sww1235/row_staggered_split_keyboard/right-pcb/row_staggered_split_keyboard_right_side.kicad_pcb

## KiCad design right-pcb/row_staggered_split_keyboard_right_side.kicad_pcb (2026-11-07)

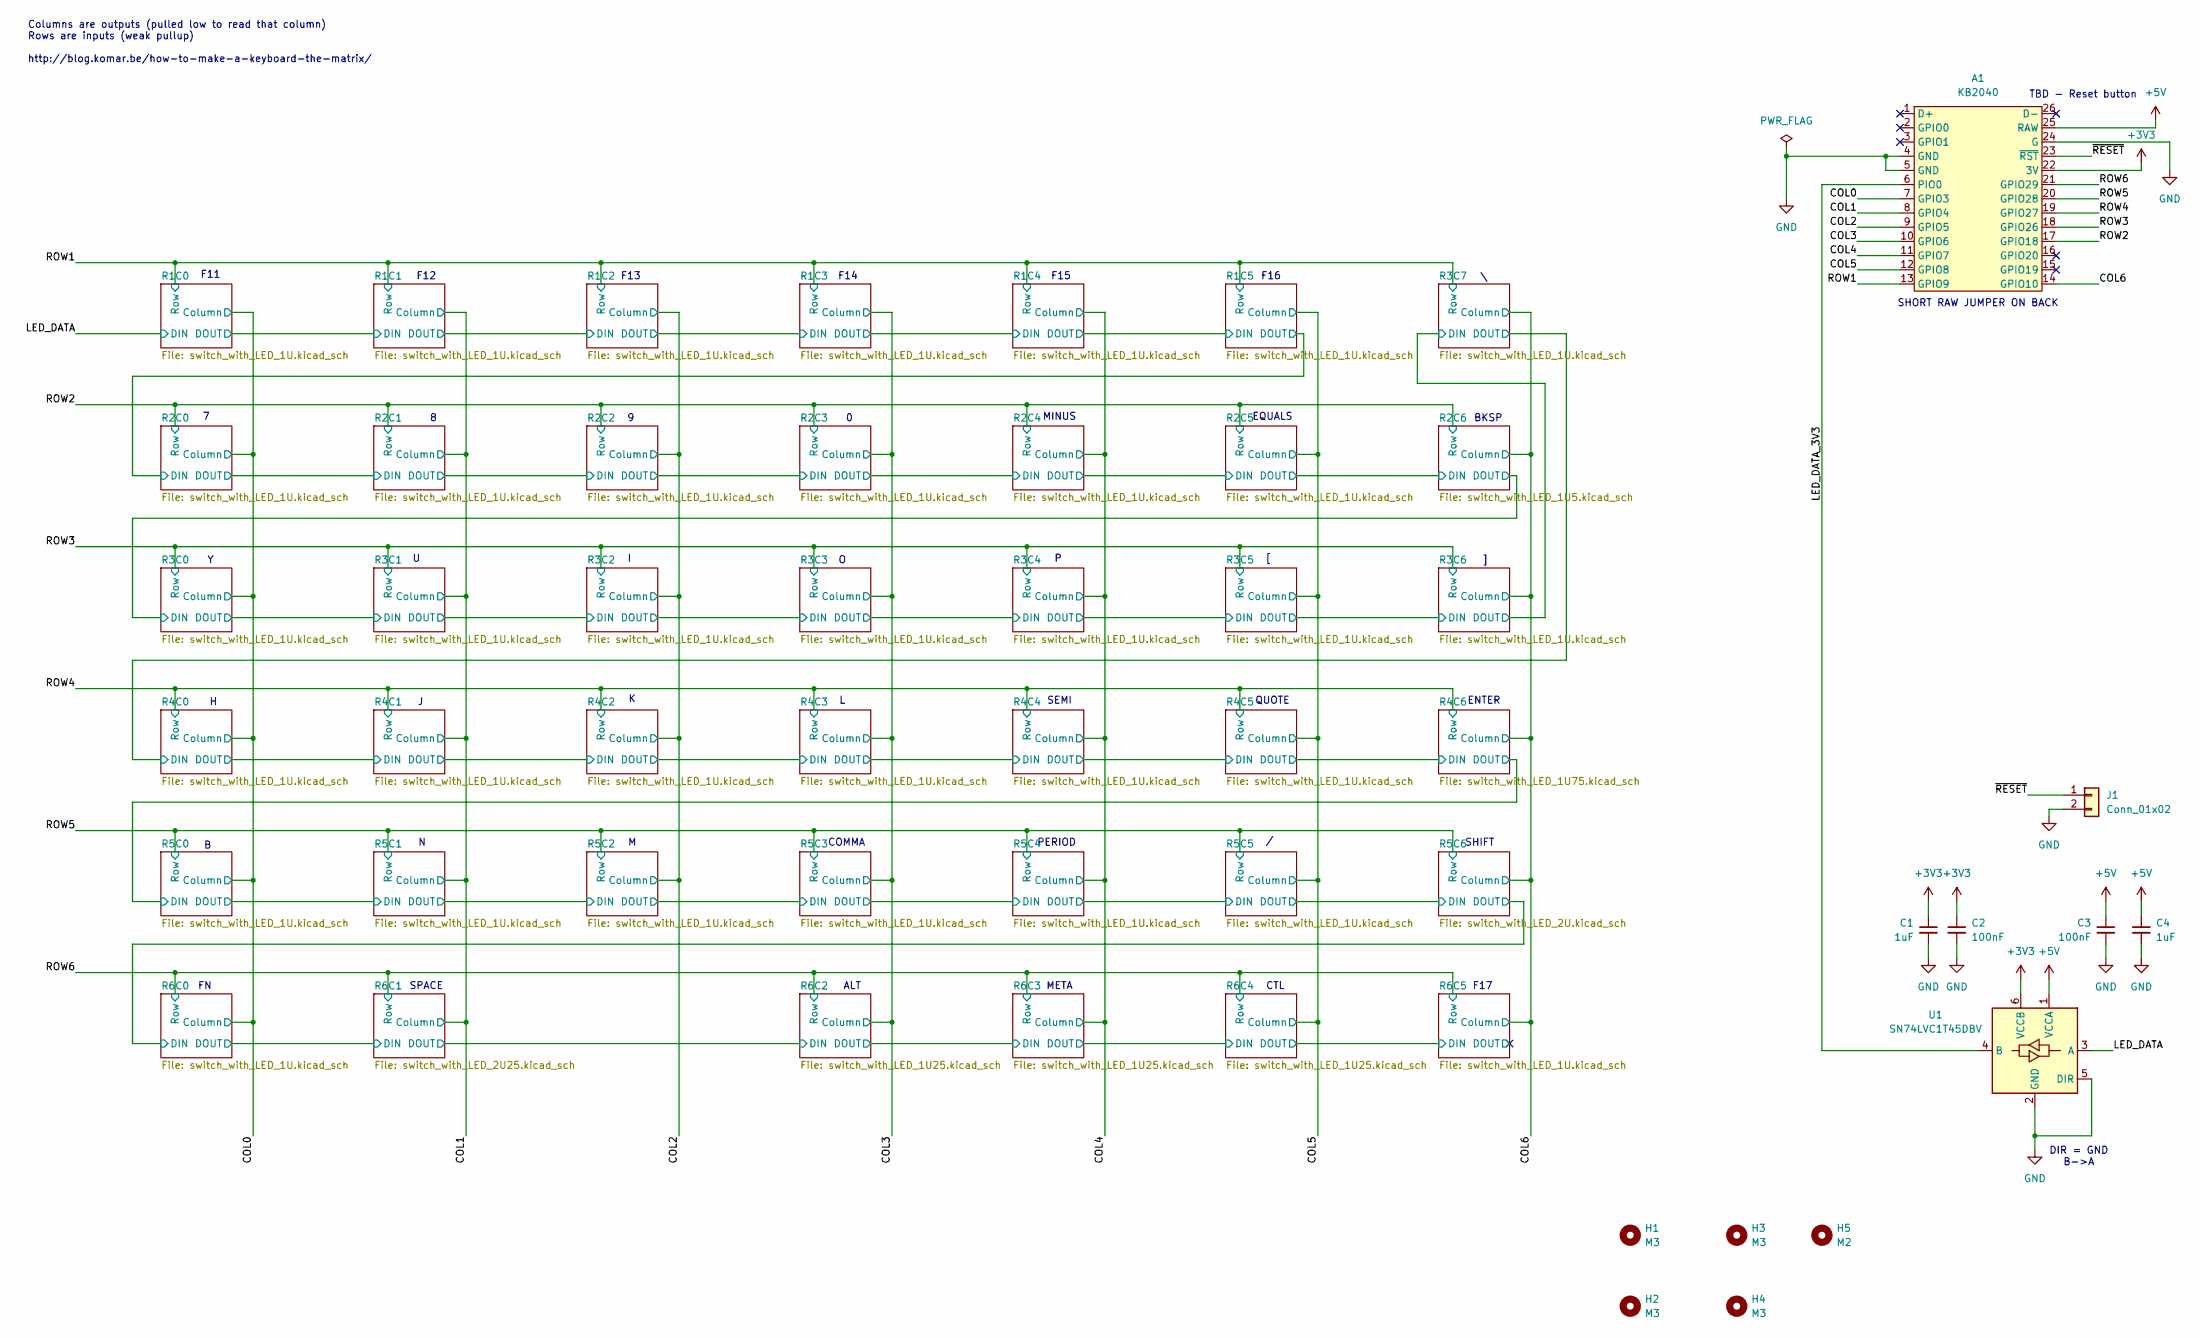
[picture p1: schematic row_staggered_split_keyboard_right_side.kicad_sch]

Parts:
A1: KB2040; KB2024_Socketed
C1, C4: 1uF; C_0805_2012Metric_Pad1.18x1.45mm_HandSolder
C2, C3: 100nF; C_0805_2012Metric_Pad1.18x1.45mm_HandSolder
H1, H2, H3, H4: M3; MountingHole_3.2mm_M3_ISO14580
H5: M2; MountingHole_2.2mm_M2
J1: Conn_01x02; PinSocket_1x02_P2.54mm_Vertical
U1: SN74LVC1T45DBV; SOT-23-6

Connections:
+3V3: A1.22 (3V), C1.1, C2.1, U1.6 (VCCB)
+5V: A1.25 (RAW), C3.1, C4.1, U1.1 (VCCA); also elsewhere on the board
/COL0: A1.7 (GPIO3); also elsewhere on the board
/COL1: A1.8 (GPIO4); also elsewhere on the board
/COL2: A1.9 (GPIO5); also elsewhere on the board
/COL3: A1.10 (GPIO6); also elsewhere on the board
/COL4: A1.11 (GPIO7); also elsewhere on the board
/COL5: A1.12 (GPIO8); also elsewhere on the board
/COL6: A1.14 (GPIO10); also elsewhere on the board
/LED_DATA: U1.3 (A); also elsewhere on the board
/LED_DATA_3V3: A1.6 (PIO0), U1.4 (B)
/ROW1: A1.13 (GPIO9); also elsewhere on the board
/ROW2: A1.17 (GPIO18); also elsewhere on the board
/ROW3: A1.18 (GPIO26); also elsewhere on the board
/ROW4: A1.19 (GPIO27); also elsewhere on the board
/ROW5: A1.20 (GPIO28); also elsewhere on the board
/ROW6: A1.21 (GPIO29); also elsewhere on the board
/~RESET: A1.23 (~RST), J1.1
GND: A1.4 (GND), A1.5 (GND), A1.24 (G), C1.2, C2.2, C3.2, C4.2, J1.2, U1.2 (GND), U1.5 (DIR); also elsewhere on the board

Notes on the sheet:
SHORT RAW JUMPER ON BACK
SPACE
DIR = GND B->A
ENTER
SHIFT
EQUALS
BKSP
F14
F15
META
MINUS
CTL
ALT
COMMA
QUOTE
F12
SEMI
F17
F13
F16
PERIOD
TBD - Reset button
Columns are outputs (pulled low to read that column) Rows are inputs (weak pullup) http://blog.komar.be/how-to-make-a-keyboard-the-matrix/
F11

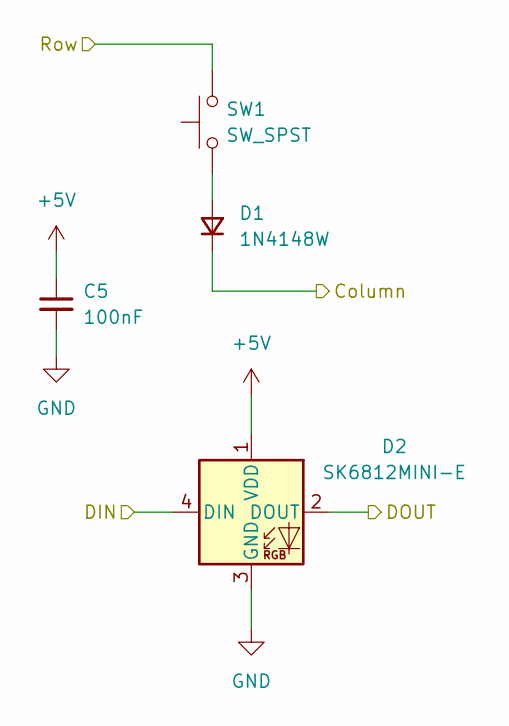
[picture p2: schematic switch_with_LED_1U.kicad_sch]

Parts:
C5: 100nF; C_0805_2012Metric_Pad1.18x1.45mm_HandSolder
D1: 1N4148W; D_SOD-123
D2: SK6812MINI-E; LED_SK6812MINI-E_REVERSE_MOUNT_3.2x2.8mm_P1.09mm
SW1: SW_SPST; SW_Hotswap_Kailh_MX_1.00u

Connections:
+5V: C5.1, D2.1 (VDD); also elsewhere on the board
/COL0: D1.1 (K); also elsewhere on the board
/LED_DATA: D2.4 (DIN); also elsewhere on the board
/R1C0/DOUT: D2.2 (DOUT); also elsewhere on the board
/ROW1: SW1.2; also elsewhere on the board
GND: C5.2, D2.3 (GND); also elsewhere on the board
unnamed: D1.2 (A), SW1.1

Parts of its further copies:
C6, C7, C8, C9, C10, C11, C12, C13, C14, C15, C16, C18, C19, C20, C21, C22, C23, C24, C25, C26, C27, C28, C29, C30, C31, C33, C34, C35, C36, C37, C38, C40, C45: 100nF; C_0805_2012Metric_Pad1.18x1.45mm_HandSolder
D3, D5, D7, D9, D11, D13, D15, D17, D19, D21, D23, D27, D29, D31, D33, D35, D37, D39, D41, D43, D45, D47, D49, D51, D53, D57, D59, D61, D63, D65, D67, D71, D81: 1N4148W; D_SOD-123
D4, D6, D8, D10, D12, D14, D16, D18, D20, D22, D24, D28, D30, D32, D34, D36, D38, D40, D42, D44, D46, D48, D50, D52, D54, D58, D60, D62, D64, D66, D68, D72, D82: SK6812MINI-E; LED_SK6812MINI-E_REVERSE_MOUNT_3.2x2.8mm_P1.09mm
SW2, SW3, SW4, SW5, SW6, SW7, SW8, SW9, SW10, SW11, SW12, SW14, SW15, SW16, SW17, SW18, SW19, SW20, SW21, SW22, SW23, SW24, SW25, SW26, SW27, SW29, SW30, SW31, SW32, SW33, SW34, SW36, SW41: SW_SPST; SW_Hotswap_Kailh_MX_1.00u

Connections of its further copies:
+5V: C6.1, C7.1, C8.1, C9.1, C10.1, C11.1, C12.1, C13.1, C14.1, C15.1, C16.1, C18.1, C19.1, C20.1, C21.1, C22.1, C23.1, C24.1, C25.1, C26.1, C27.1, C28.1, C29.1, C30.1, C31.1, C33.1, C34.1, C35.1, C36.1, C37.1, C38.1, C40.1, C45.1, D4.1 (VDD), D6.1 (VDD), D8.1 (VDD), D10.1 (VDD), D12.1 (VDD), D14.1 (VDD), D16.1 (VDD), D18.1 (VDD), D20.1 (VDD), D22.1 (VDD), D24.1 (VDD), D28.1 (VDD), D30.1 (VDD), D32.1 (VDD), D34.1 (VDD), D36.1 (VDD), D38.1 (VDD), D40.1 (VDD), D42.1 (VDD), D44.1 (VDD), D46.1 (VDD), D48.1 (VDD), D50.1 (VDD), D52.1 (VDD), D54.1 (VDD), D58.1 (VDD), D60.1 (VDD), D62.1 (VDD), D64.1 (VDD), D66.1 (VDD), D68.1 (VDD), D72.1 (VDD), D82.1 (VDD); also elsewhere on the board
/COL0: D13.1 (K), D27.1 (K), D43.1 (K), D57.1 (K), D71.1 (K); also elsewhere on the board
/COL1: D3.1 (K), D15.1 (K), D29.1 (K), D45.1 (K), D59.1 (K); also elsewhere on the board
/COL2: D5.1 (K), D17.1 (K), D31.1 (K), D47.1 (K), D61.1 (K); also elsewhere on the board
/COL3: D7.1 (K), D19.1 (K), D33.1 (K), D49.1 (K), D63.1 (K); also elsewhere on the board
/COL4: D9.1 (K), D21.1 (K), D35.1 (K), D51.1 (K), D65.1 (K); also elsewhere on the board
/COL5: D11.1 (K), D23.1 (K), D37.1 (K), D53.1 (K), D67.1 (K); also elsewhere on the board
/COL6: D39.1 (K), D41.1 (K), D81.1 (K); also elsewhere on the board
/R1C0/DOUT: D4.4 (DIN); also elsewhere on the board
/R1C1/DOUT: D4.2 (DOUT), D6.4 (DIN)
/R1C2/DOUT: D6.2 (DOUT), D8.4 (DIN)
/R1C3/DOUT: D8.2 (DOUT), D10.4 (DIN)
/R1C4/DOUT: D10.2 (DOUT), D12.4 (DIN)
/R1C5/DOUT: D12.2 (DOUT), D14.4 (DIN)
/R2C0/DOUT: D14.2 (DOUT), D16.4 (DIN)
/R2C1/DOUT: D16.2 (DOUT), D18.4 (DIN)
/R2C2/DOUT: D18.2 (DOUT), D20.4 (DIN)
/R2C3/DOUT: D20.2 (DOUT), D22.4 (DIN)
/R2C4/DOUT: D22.2 (DOUT), D24.4 (DIN)
/R2C5/DOUT: D24.2 (DOUT); also elsewhere on the board
/R2C6/DOUT: D28.4 (DIN); also elsewhere on the board
/R3C0/DOUT: D28.2 (DOUT), D30.4 (DIN)
/R3C1/DOUT: D30.2 (DOUT), D32.4 (DIN)
/R3C2/DOUT: D32.2 (DOUT), D34.4 (DIN)
/R3C3/DOUT: D34.2 (DOUT), D36.4 (DIN)
/R3C4/DOUT: D36.2 (DOUT), D38.4 (DIN)
/R3C5/DOUT: D38.2 (DOUT), D40.4 (DIN)
/R3C6/DOUT: D40.2 (DOUT), D42.4 (DIN)
/R3C7/DOUT: D42.2 (DOUT), D44.4 (DIN)
/R4C0/DOUT: D44.2 (DOUT), D46.4 (DIN)
/R4C1/DOUT: D46.2 (DOUT), D48.4 (DIN)
/R4C2/DOUT: D48.2 (DOUT), D50.4 (DIN)
/R4C3/DOUT: D50.2 (DOUT), D52.4 (DIN)
/R4C4/DOUT: D52.2 (DOUT), D54.4 (DIN)
/R4C5/DOUT: D54.2 (DOUT); also elsewhere on the board
/R4C6/DOUT: D58.4 (DIN); also elsewhere on the board
/R5C0/DOUT: D58.2 (DOUT), D60.4 (DIN)
/R5C1/DOUT: D60.2 (DOUT), D62.4 (DIN)
/R5C2/DOUT: D62.2 (DOUT), D64.4 (DIN)
/R5C3/DOUT: D64.2 (DOUT), D66.4 (DIN)
/R5C4/DOUT: D66.2 (DOUT), D68.4 (DIN)
/R5C5/DOUT: D68.2 (DOUT); also elsewhere on the board
/R5C6/DOUT: D72.4 (DIN); also elsewhere on the board
/R6C0/DOUT: D72.2 (DOUT); also elsewhere on the board
/R6C4/DOUT: D82.4 (DIN); also elsewhere on the board
/R6C5/DOUT: D82.2 (DOUT)
/ROW1: SW2.2, SW3.2, SW4.2, SW5.2, SW6.2, SW21.2; also elsewhere on the board
/ROW2: SW7.2, SW8.2, SW9.2, SW10.2, SW11.2, SW12.2; also elsewhere on the board
/ROW3: SW14.2, SW15.2, SW16.2, SW17.2, SW18.2, SW19.2, SW20.2; also elsewhere on the board
/ROW4: SW22.2, SW23.2, SW24.2, SW25.2, SW26.2, SW27.2; also elsewhere on the board
/ROW5: SW29.2, SW30.2, SW31.2, SW32.2, SW33.2, SW34.2; also elsewhere on the board
/ROW6: SW36.2, SW41.2; also elsewhere on the board
GND: C6.2, C7.2, C8.2, C9.2, C10.2, C11.2, C12.2, C13.2, C14.2, C15.2, C16.2, C18.2, C19.2, C20.2, C21.2, C22.2, C23.2, C24.2, C25.2, C26.2, C27.2, C28.2, C29.2, C30.2, C31.2, C33.2, C34.2, C35.2, C36.2, C37.2, C38.2, C40.2, C45.2, D4.3 (GND), D6.3 (GND), D8.3 (GND), D10.3 (GND), D12.3 (GND), D14.3 (GND), D16.3 (GND), D18.3 (GND), D20.3 (GND), D22.3 (GND), D24.3 (GND), D28.3 (GND), D30.3 (GND), D32.3 (GND), D34.3 (GND), D36.3 (GND), D38.3 (GND), D40.3 (GND), D42.3 (GND), D44.3 (GND), D46.3 (GND), D48.3 (GND), D50.3 (GND), D52.3 (GND), D54.3 (GND), D58.3 (GND), D60.3 (GND), D62.3 (GND), D64.3 (GND), D66.3 (GND), D68.3 (GND), D72.3 (GND), D82.3 (GND); also elsewhere on the board
unnamed: D3.2 (A), SW2.1
unnamed: D5.2 (A), SW3.1
unnamed: D7.2 (A), SW4.1
unnamed: D9.2 (A), SW5.1
unnamed: D11.2 (A), SW6.1
unnamed: D13.2 (A), SW7.1
unnamed: D15.2 (A), SW8.1
unnamed: D17.2 (A), SW9.1
unnamed: D19.2 (A), SW10.1
unnamed: D21.2 (A), SW11.1
unnamed: D23.2 (A), SW12.1
unnamed: D27.2 (A), SW14.1
unnamed: D29.2 (A), SW15.1
unnamed: D31.2 (A), SW16.1
unnamed: D33.2 (A), SW17.1
unnamed: D35.2 (A), SW18.1
unnamed: D37.2 (A), SW19.1
unnamed: D39.2 (A), SW20.1
unnamed: D41.2 (A), SW21.1
unnamed: D43.2 (A), SW22.1
unnamed: D45.2 (A), SW23.1
unnamed: D47.2 (A), SW24.1
unnamed: D49.2 (A), SW25.1
unnamed: D51.2 (A), SW26.1
unnamed: D53.2 (A), SW27.1
unnamed: D57.2 (A), SW29.1
unnamed: D59.2 (A), SW30.1
unnamed: D61.2 (A), SW31.1
unnamed: D63.2 (A), SW32.1
unnamed: D65.2 (A), SW33.1
unnamed: D67.2 (A), SW34.1
unnamed: D71.2 (A), SW36.1
unnamed: D81.2 (A), SW41.1

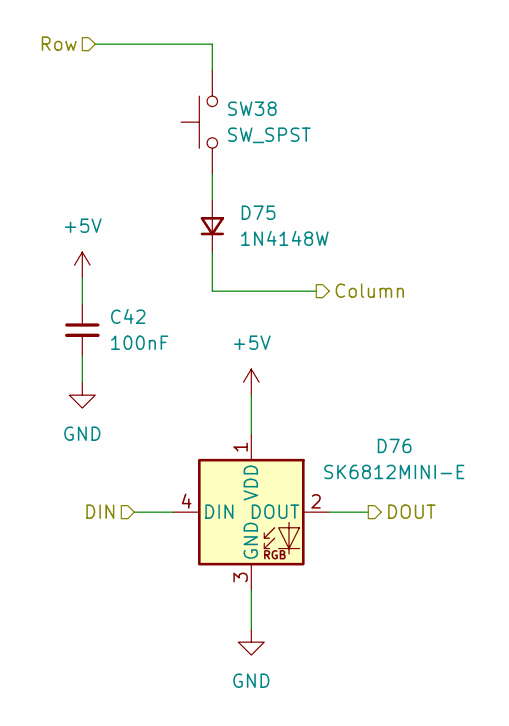
[picture p3: schematic switch_with_LED_1U25.kicad_sch]

Parts:
C42: 100nF; C_0805_2012Metric_Pad1.18x1.45mm_HandSolder
D75: 1N4148W; D_SOD-123
D76: SK6812MINI-E; LED_SK6812MINI-E_REVERSE_MOUNT_3.2x2.8mm_P1.09mm
SW38: SW_SPST; SW_Hotswap_Kailh_MX_1.25u

Connections:
+5V: C42.1, D76.1 (VDD); also elsewhere on the board
/COL3: D75.1 (K); also elsewhere on the board
/R6C1/DOUT: D76.4 (DIN); also elsewhere on the board
/R6C2/DOUT: D76.2 (DOUT); also elsewhere on the board
/ROW6: SW38.2; also elsewhere on the board
GND: C42.2, D76.3 (GND); also elsewhere on the board
unnamed: D75.2 (A), SW38.1

Parts of its further copies:
C43, C44: 100nF; C_0805_2012Metric_Pad1.18x1.45mm_HandSolder
D77, D79: 1N4148W; D_SOD-123
D78, D80: SK6812MINI-E; LED_SK6812MINI-E_REVERSE_MOUNT_3.2x2.8mm_P1.09mm
SW39, SW40: SW_SPST; SW_Hotswap_Kailh_MX_1.25u

Connections of its further copies:
+5V: C43.1, C44.1, D78.1 (VDD), D80.1 (VDD); also elsewhere on the board
/COL4: D77.1 (K); also elsewhere on the board
/COL5: D79.1 (K); also elsewhere on the board
/R6C2/DOUT: D78.4 (DIN); also elsewhere on the board
/R6C3/DOUT: D78.2 (DOUT), D80.4 (DIN)
/R6C4/DOUT: D80.2 (DOUT); also elsewhere on the board
/ROW6: SW39.2, SW40.2; also elsewhere on the board
GND: C43.2, C44.2, D78.3 (GND), D80.3 (GND); also elsewhere on the board
unnamed: D77.2 (A), SW39.1
unnamed: D79.2 (A), SW40.1

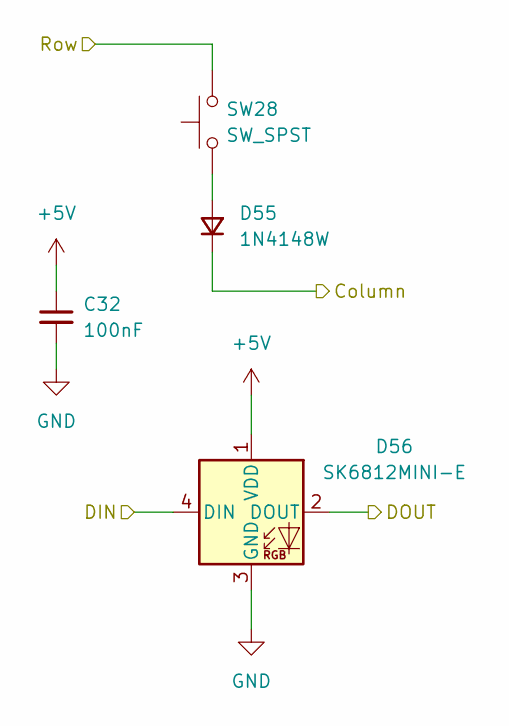
[picture p4: schematic switch_with_LED_1U75.kicad_sch]

Parts:
C32: 100nF; C_0805_2012Metric_Pad1.18x1.45mm_HandSolder
D55: 1N4148W; D_SOD-123
D56: SK6812MINI-E; LED_SK6812MINI-E_REVERSE_MOUNT_3.2x2.8mm_P1.09mm
SW28: SW_SPST; SW_Hotswap_Kailh_MX_1.75u

Connections:
+5V: C32.1, D56.1 (VDD); also elsewhere on the board
/COL6: D55.1 (K); also elsewhere on the board
/R4C5/DOUT: D56.4 (DIN); also elsewhere on the board
/R4C6/DOUT: D56.2 (DOUT); also elsewhere on the board
/ROW4: SW28.2; also elsewhere on the board
GND: C32.2, D56.3 (GND); also elsewhere on the board
unnamed: D55.2 (A), SW28.1

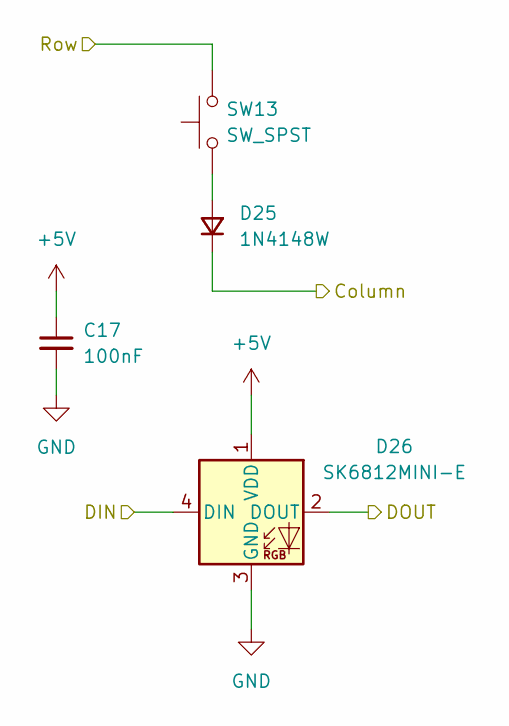
[picture p5: schematic switch_with_LED_1U5.kicad_sch]

Parts:
C17: 100nF; C_0805_2012Metric_Pad1.18x1.45mm_HandSolder
D25: 1N4148W; D_SOD-123
D26: SK6812MINI-E; LED_SK6812MINI-E_REVERSE_MOUNT_3.2x2.8mm_P1.09mm
SW13: SW_SPST; SW_Hotswap_Kailh_MX_1.50u

Connections:
+5V: C17.1, D26.1 (VDD); also elsewhere on the board
/COL6: D25.1 (K); also elsewhere on the board
/R2C5/DOUT: D26.4 (DIN); also elsewhere on the board
/R2C6/DOUT: D26.2 (DOUT); also elsewhere on the board
/ROW2: SW13.2; also elsewhere on the board
GND: C17.2, D26.3 (GND); also elsewhere on the board
unnamed: D25.2 (A), SW13.1

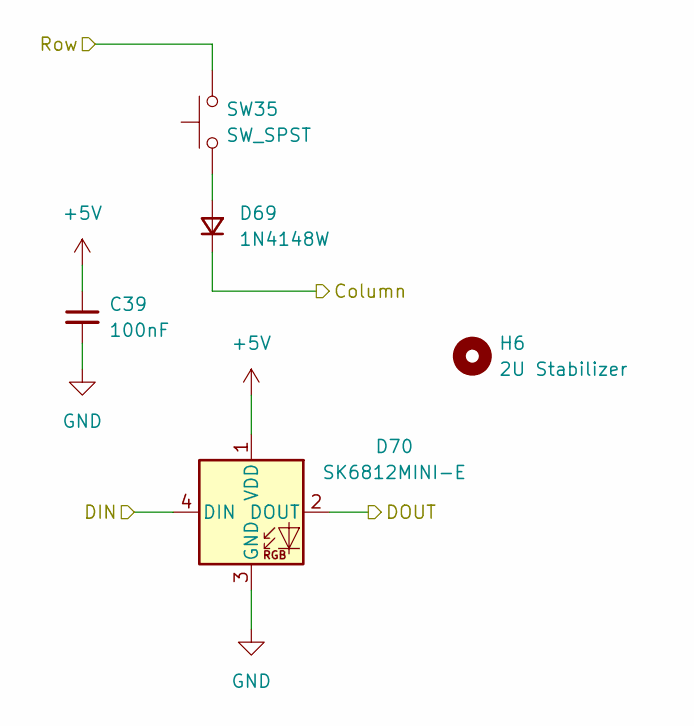
[picture p6: schematic switch_with_LED_2U.kicad_sch]

Parts:
C39: 100nF; C_0805_2012Metric_Pad1.18x1.45mm_HandSolder
D69: 1N4148W; D_SOD-123
D70: SK6812MINI-E; LED_SK6812MINI-E_REVERSE_MOUNT_3.2x2.8mm_P1.09mm
H6: 2U Stabilizer; Stabilizer_Cherry_MX_2.00u
SW35: SW_SPST; SW_Hotswap_Kailh_MX_2.00u

Connections:
+5V: C39.1, D70.1 (VDD); also elsewhere on the board
/COL6: D69.1 (K); also elsewhere on the board
/R5C5/DOUT: D70.4 (DIN); also elsewhere on the board
/R5C6/DOUT: D70.2 (DOUT); also elsewhere on the board
/ROW5: SW35.2; also elsewhere on the board
GND: C39.2, D70.3 (GND); also elsewhere on the board
unnamed: D69.2 (A), SW35.1

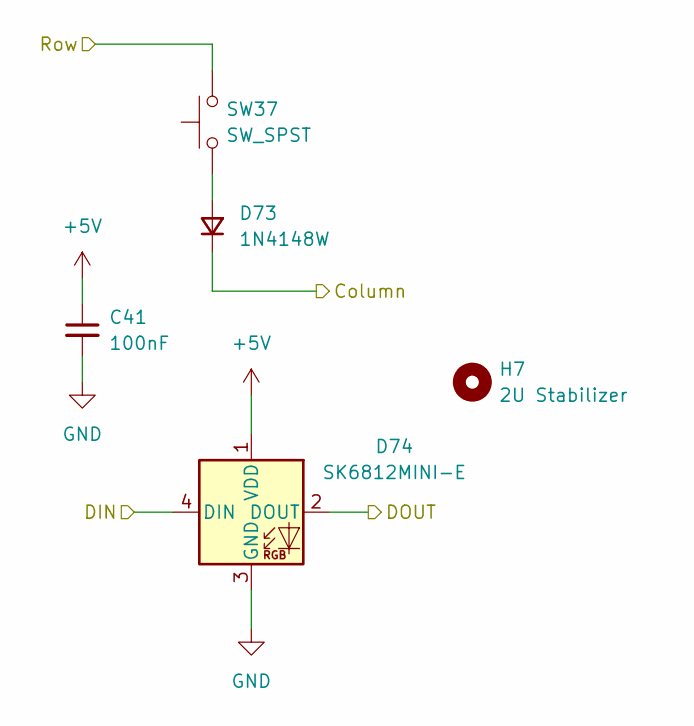
[picture p7: schematic switch_with_LED_2U25.kicad_sch]

Parts:
C41: 100nF; C_0805_2012Metric_Pad1.18x1.45mm_HandSolder
D73: 1N4148W; D_SOD-123
D74: SK6812MINI-E; LED_SK6812MINI-E_REVERSE_MOUNT_3.2x2.8mm_P1.09mm
H7: 2U Stabilizer; Stabilizer_Cherry_MX_2.00u
SW37: SW_SPST; SW_Hotswap_Kailh_MX_2.25u

Connections:
+5V: C41.1, D74.1 (VDD); also elsewhere on the board
/COL1: D73.1 (K); also elsewhere on the board
/R6C0/DOUT: D74.4 (DIN); also elsewhere on the board
/R6C1/DOUT: D74.2 (DOUT); also elsewhere on the board
/ROW6: SW37.2; also elsewhere on the board
GND: C41.2, D74.3 (GND); also elsewhere on the board
unnamed: D73.2 (A), SW37.1

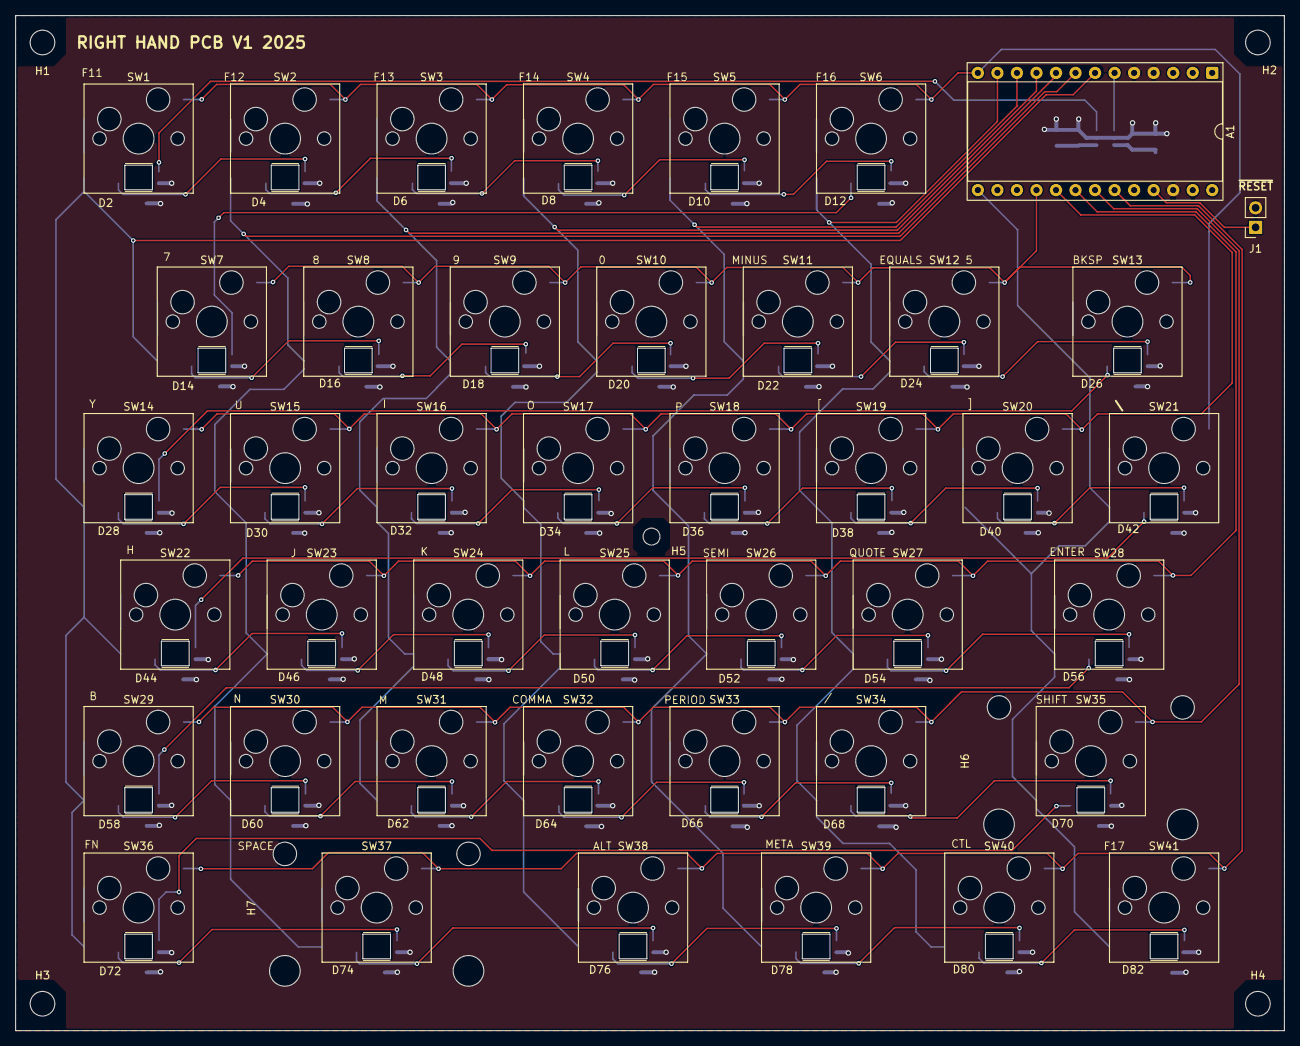
[picture p8: board row_staggered_split_keyboard_right_side.kicad_pcb from above]

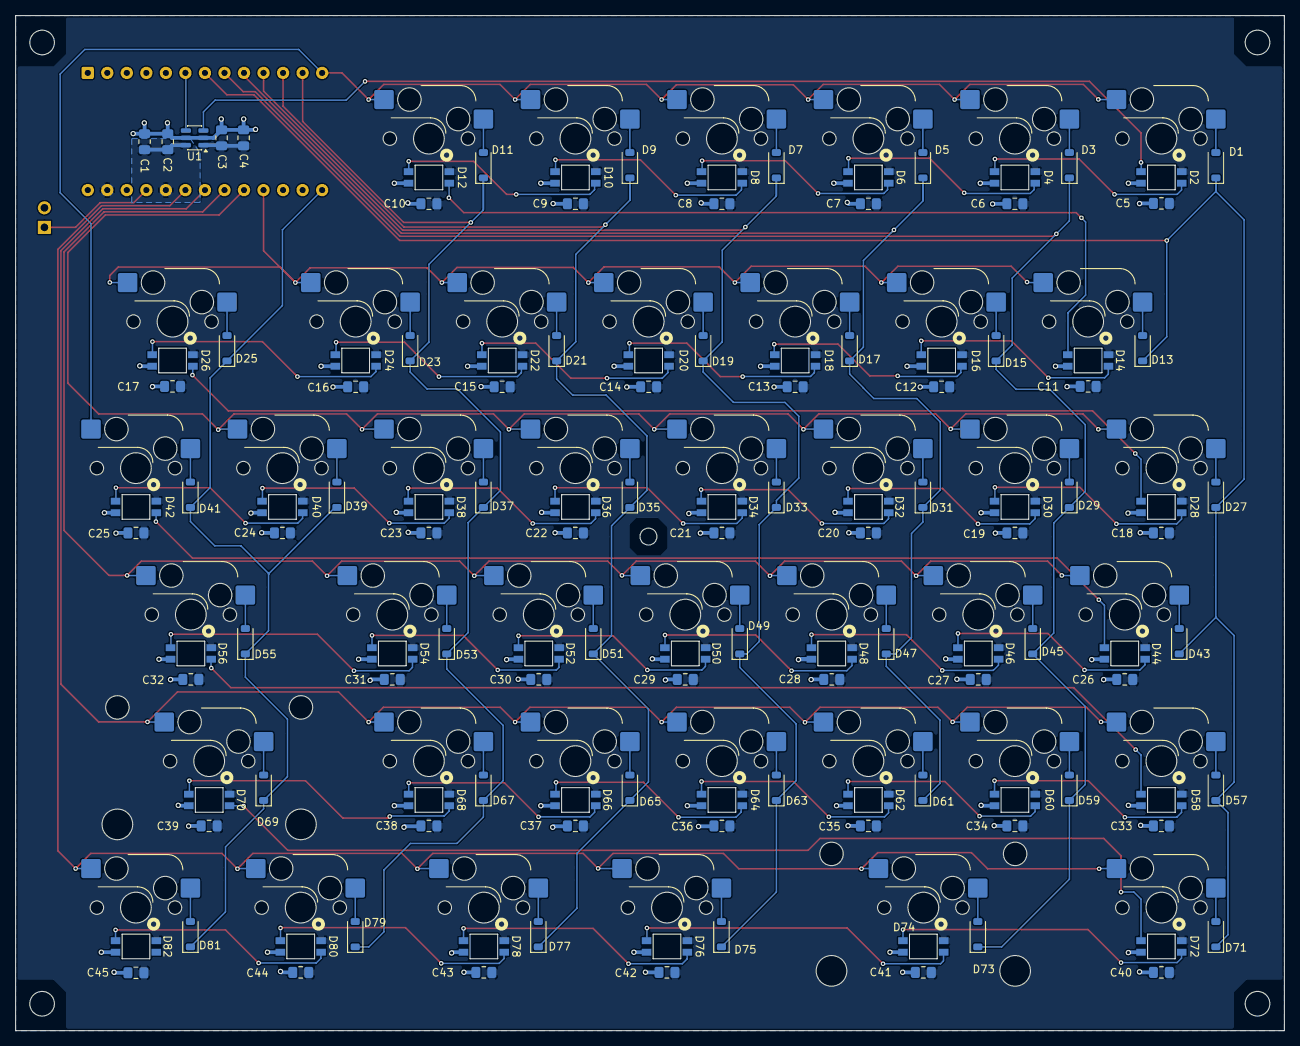
[picture p9: board row_staggered_split_keyboard_right_side.kicad_pcb from below]

Board: 2 copper layers, 165.0 x 132.0 mm, 178 parts (87 on the bottom side), 100 nets.
