sww1235/row_staggered_split_keyboard/(commit log)

2025-10-16 initial commit of schematic and pcb
    [row_staggered_split_keyboard.kicad_pcb, row_staggered_split_keyboard.kicad_sch, switch_with_LED.kicad_sch]
2025-10-18 renamed files anticipating right side project
    [row_staggered_split_keyboard_left_side.kicad_pcb, row_staggered_split_keyboard_left_side.kicad_sch, switch_with_LED.kicad_sch]
2025-10-19 Updating schematic with different size keys
    Also updated LED data wiring to correspond with PCB layout
    [row_staggered_split_keyboard_left_side.kicad_sch, switch_with_LED_1U.kicad_sch, switch_with_LED_1U25.kicad_sch, switch_with_LED_1U5.kicad_sch, switch_with_LED_1U75.kicad_sch, switch_with_LED_2U.kicad_sch, switch_with_LED_2U25.kicad_sch]
2025-10-20 Next revision of PCB
    [row_staggered_split_keyboard_left_side.kicad_pcb, row_staggered_split_keyboard_left_side.kicad_sch, switch_with_LED_1U.kicad_sch, switch_with_LED_2U.kicad_sch]
2025-10-21 Initial modifications to reduce fab cost and add caps
    Removing 1 row and column of keys, and majorly changing layout
    Routing still in progress
    [row_staggered_split_keyboard_left_side.kicad_pcb, row_staggered_split_keyboard_left_side.kicad_sch, switch_with_LED_1U.kicad_sch, switch_with_LED_1U25.kicad_sch, switch_with_LED_1U5.kicad_sch, switch_with_LED_1U75.kicad_sch, switch_with_LED_2U.kicad_sch, switch_with_LED_2U25.kicad_sch]
2025-10-22 Caps, shrunk board, added mounting holes
    [row_staggered_split_keyboard_left_side.kicad_pcb, row_staggered_split_keyboard_left_side.kicad_sch, switch_with_LED_1U.kicad_sch, switch_with_LED_1U25.kicad_sch, switch_with_LED_1U5.kicad_sch, switch_with_LED_1U75.kicad_sch, switch_with_LED_2U.kicad_sch, switch_with_LED_2U25.kicad_sch]
2025-10-22 Added exterior dimension indication to board
    [row_staggered_split_keyboard_left_side.kicad_pcb]
2025-10-29 Adding values to Diodes and adding stabilizers to 2U switches
    [row_staggered_split_keyboard_left_side.kicad_pcb, switch_with_LED_1U.kicad_sch, switch_with_LED_1U25.kicad_sch, switch_with_LED_1U5.kicad_sch, switch_with_LED_1U75.kicad_sch, switch_with_LED_2U.kicad_sch, switch_with_LED_2U25.kicad_sch]
2025-10-29 forgot to update diode values in PCB
    [row_staggered_split_keyboard_left_side.kicad_pcb]
2025-10-30 Added extra column to left hand keyboard
    Matching size to right hand side.
    [row_staggered_split_keyboard_left_side.kicad_pcb, row_staggered_split_keyboard_left_side.kicad_sch, switch_with_LED_1U.kicad_sch, switch_with_LED_1U25.kicad_sch, switch_with_LED_1U5.kicad_sch, switch_with_LED_1U75.kicad_sch, switch_with_LED_2U.kicad_sch, switch_with_LED_2U25.kicad_sch]
2025-11-02 locked mounting hole positions and board edges
    [row_staggered_split_keyboard_left_side.kicad_pcb]
2025-11-02 initial commit of right hand pcb
    [row_staggered_split_keyboard_right_side.kicad_pcb, row_staggered_split_keyboard_right_side.kicad_sch, switch_with_LED_1.kicad_sch, switch_with_LED_1U.kicad_sch, switch_with_LED_1U25.kicad_sch, switch_with_LED_1U5.kicad_sch, switch_with_LED_1U75.kicad_sch, switch_with_LED_2U.kicad_sch]
2025-11-02 initial placement of switches and modifications from left to right
    [row_staggered_split_keyboard_right_side.kicad_pcb, row_staggered_split_keyboard_right_side.kicad_sch, switch_with_LED_1.kicad_sch, switch_with_LED_1U.kicad_sch, switch_with_LED_1U25.kicad_sch, switch_with_LED_1U5.kicad_sch, switch_with_LED_1U75.kicad_sch, switch_with_LED_2U.kicad_sch]
2025-11-03 a bunch of DRC fixes and pcb work
    [row_staggered_split_keyboard_right_side.kicad_pcb, row_staggered_split_keyboard_right_side.kicad_sch]
2025-11-03 locking edge_cuts and holes
    [row_staggered_split_keyboard_right_side.kicad_pcb]
2025-11-03 reworking LED data lines to eliminate ground plane disconnections
    [row_staggered_split_keyboard_left_side.kicad_pcb, row_staggered_split_keyboard_left_side.kicad_sch, row_staggered_split_keyboard_right_side.kicad_pcb]
2025-11-03 duplicate track cleanup and avoiding silkscreen with tracks
    [row_staggered_split_keyboard_left_side.kicad_pcb, row_staggered_split_keyboard_right_side.kicad_pcb]
2025-11-09 Silkscreen cleanup and trace cleanup in prep for PCB review posting
    [row_staggered_split_keyboard_left_side.kicad_pcb, row_staggered_split_keyboard_left_side.kicad_sch, row_staggered_split_keyboard_right_side.kicad_pcb, row_staggered_split_keyboard_right_side.kicad_sch]
2025-11-09 adding SVGs of schematic and PCB used for v1 review
2026-02-21 applied feedback from coworker
    [row_staggered_split_keyboard_left_side.kicad_pcb, row_staggered_split_keyboard_right_side.kicad_pcb]
2026-05-27 updating for KiCAD 10.0
    [row_staggered_split_keyboard_left_side.kicad_pcb, row_staggered_split_keyboard_left_side.kicad_sch, row_staggered_split_keyboard_right_side.kicad_pcb, row_staggered_split_keyboard_right_side.kicad_sch, switch_with_LED_1U.kicad_sch, switch_with_LED_1U25.kicad_sch, switch_with_LED_1U5.kicad_sch, switch_with_LED_1U75.kicad_sch]
2026-05-29 adding mounting hole in center for additional support, and cleaning up tracks/zones
    [row_staggered_split_keyboard_left_side.kicad_pcb, row_staggered_split_keyboard_left_side.kicad_sch, row_staggered_split_keyboard_right_side.kicad_pcb, row_staggered_split_keyboard_right_side.kicad_sch, switch_with_LED_1U.kicad_sch, switch_with_LED_1U25.kicad_sch, switch_with_LED_1U5.kicad_sch, switch_with_LED_1U75.kicad_sch]
2026-05-31 ignoring generated gerber files
2026-05-31 fixed that some components were not included in the BOM
    [row_staggered_split_keyboard_left_side.kicad_pcb, row_staggered_split_keyboard_left_side.kicad_sch, row_staggered_split_keyboard_right_side.kicad_pcb]
2026-06-20 Boards were ordered
    [row_staggered_split_keyboard_left_side.kicad_pcb, row_staggered_split_keyboard_right_side.kicad_pcb, switch_with_LED_1U.kicad_sch, switch_with_LED_1U25.kicad_sch, switch_with_LED_1U5.kicad_sch, switch_with_LED_1U75.kicad_sch, switch_with_LED_2U.kicad_sch, switch_with_LED_2U25.kicad_sch]
2026-10-31 Fixing silkscreen errors
2026-11-07 fixed dimensions on right hand pcb
